faizaheljoasaariesta/monocopter/design/cup.stp

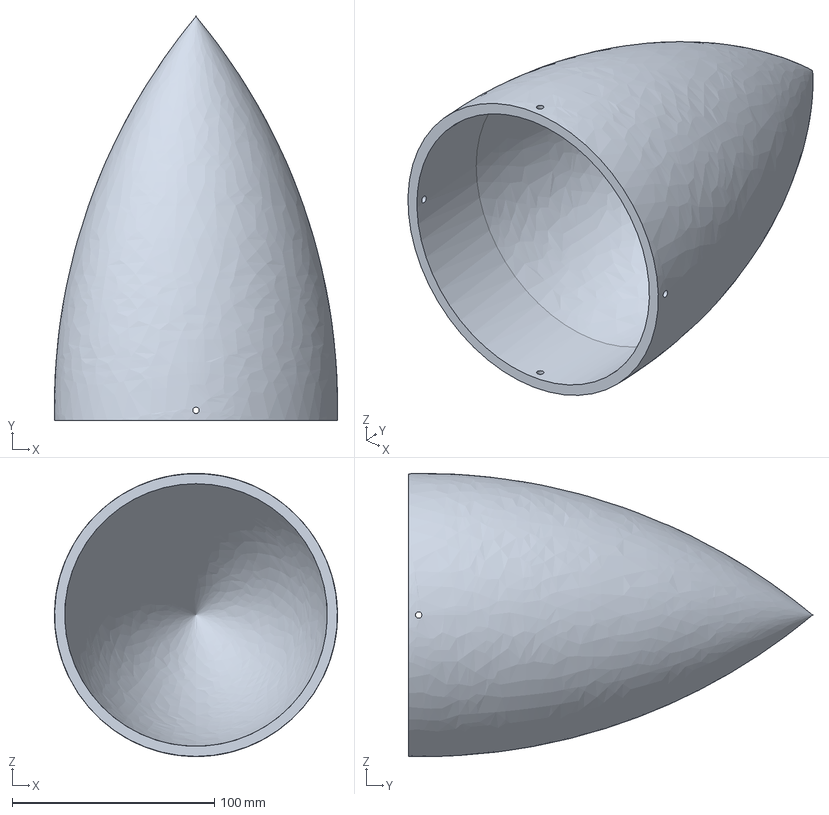
[picture p1: CAD file, 2026-10-10]
design/cup.stp
140.2 x 200.0 x 140.2 mm
