faizaheljoasaariesta/monocopter/design/battery_holder.stp

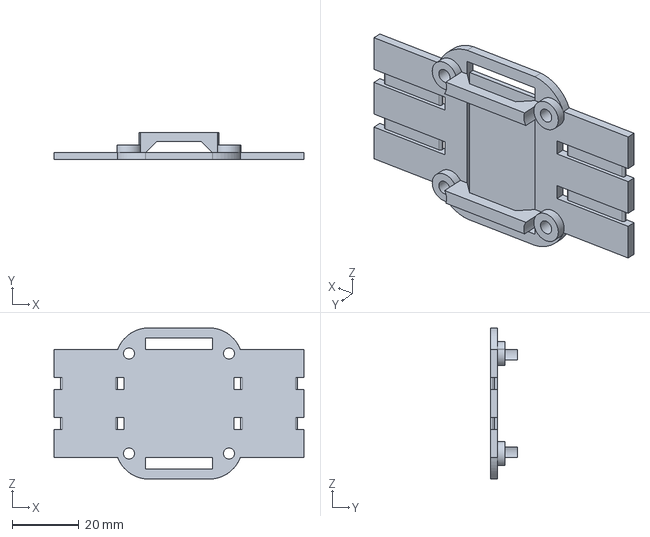
[picture p2: CAD file, 2026-10-10]
design/battery_holder.stp
75.0 x 8.20 x 45.3 mm
