faizaheljoasaariesta/monocopter/design/base_connection.stp

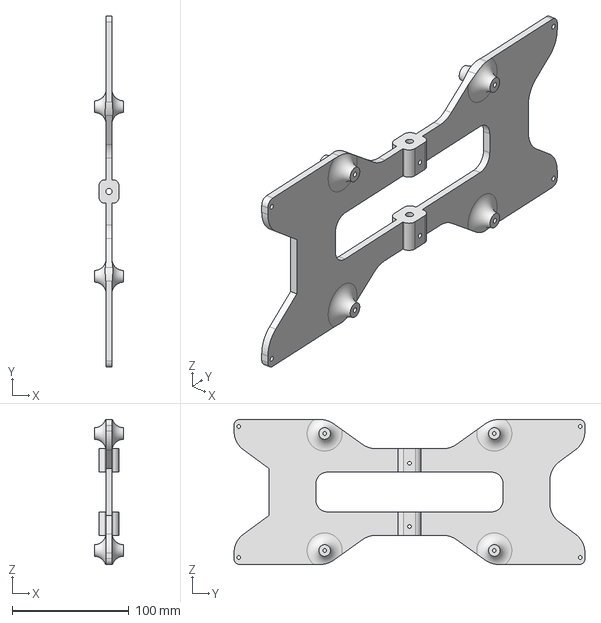
[picture p3: CAD file, 2026-10-10]
design/base_connection.stp
25.0 x 300.0 x 124.0 mm
