faizaheljoasaariesta/monocopter/design/body.stp

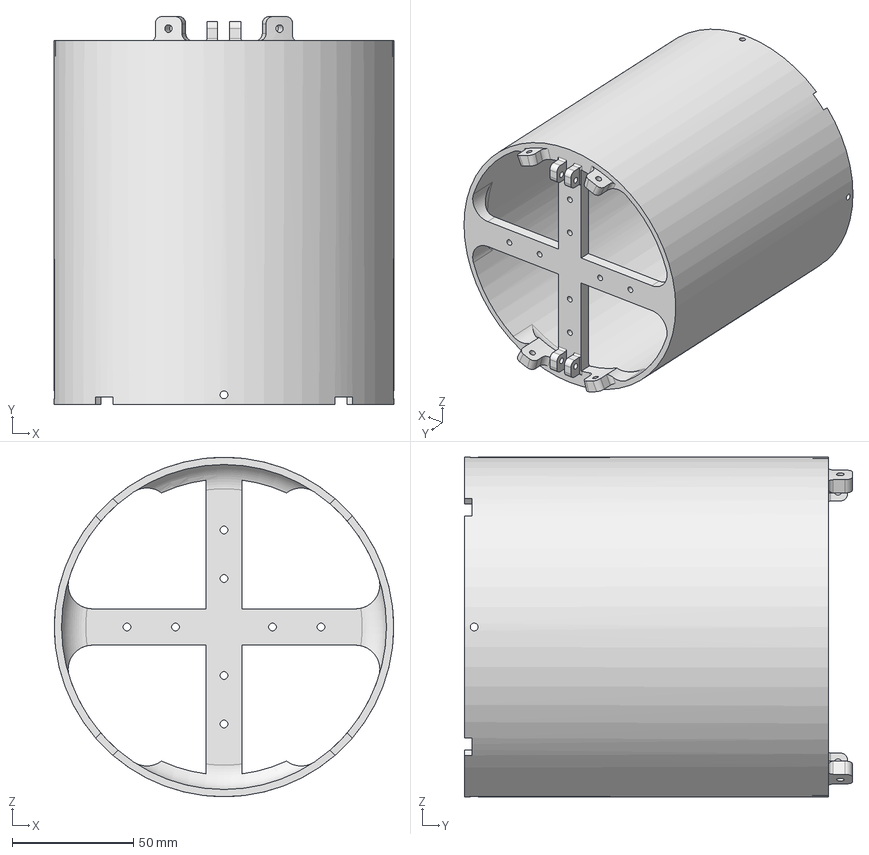
[picture p4: CAD file, 2026-10-10]
design/body.stp
140.0 x 160.0 x 140.0 mm
