faizaheljoasaariesta/monocopter/design/upper_ring.stp

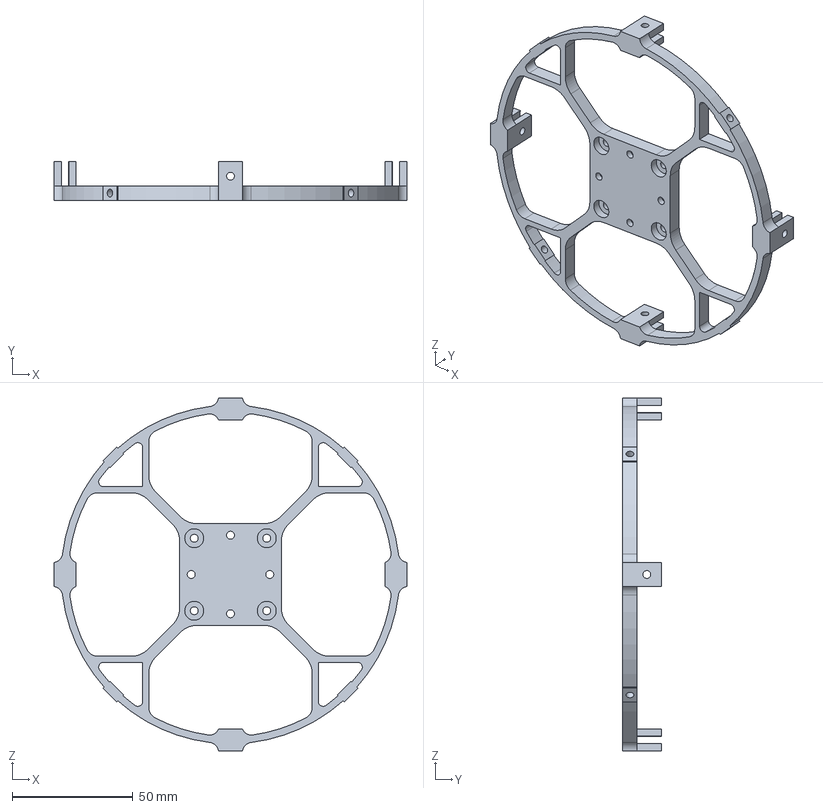
[picture p5: CAD file, 2026-10-10]
design/upper_ring.stp
146.0 x 16.0 x 146.0 mm
