faizaheljoasaariesta/monocopter/design/vane.stp

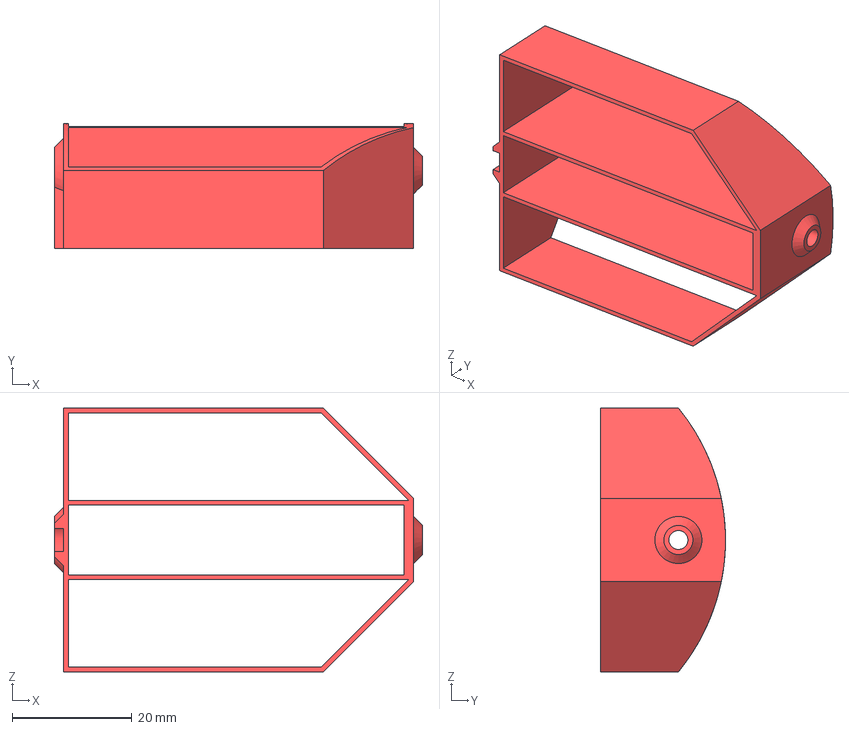
[picture p6: CAD file, 2026-10-10]
design/vane.stp
61.4 x 20.9 x 44.0 mm
