faizaheljoasaariesta/monocopter/design/lower_ring.stp

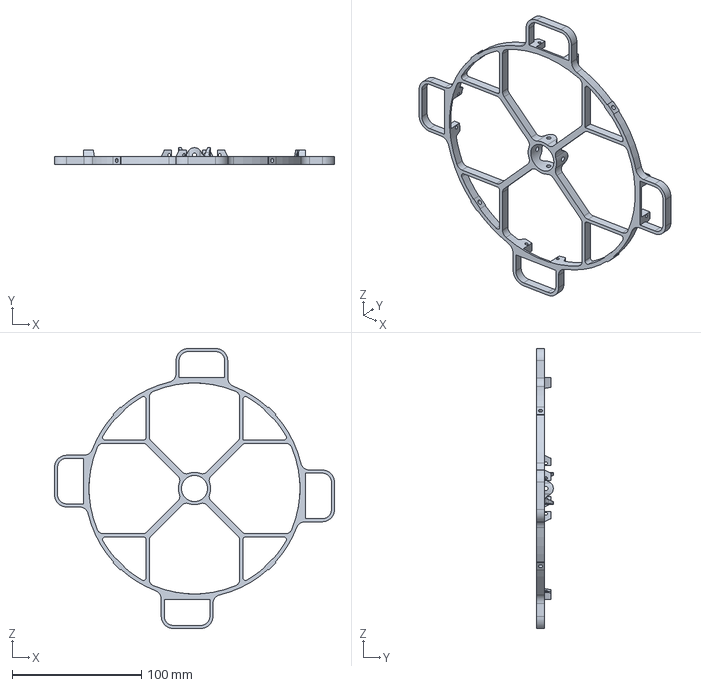
[picture p7: CAD file, 2026-10-10]
design/lower_ring.stp
216.6 x 12.8 x 216.6 mm
