faizaheljoasaariesta/monocopter/design/leg.stp

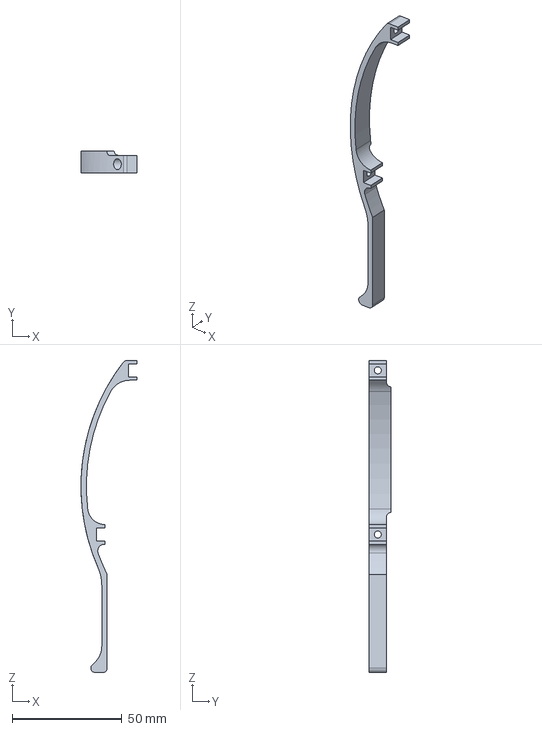
[picture p8: CAD file, 2026-10-10]
design/leg.stp
25.6 x 10.0 x 142.4 mm
