faizaheljoasaariesta/monocopter/design/body_middle.stp

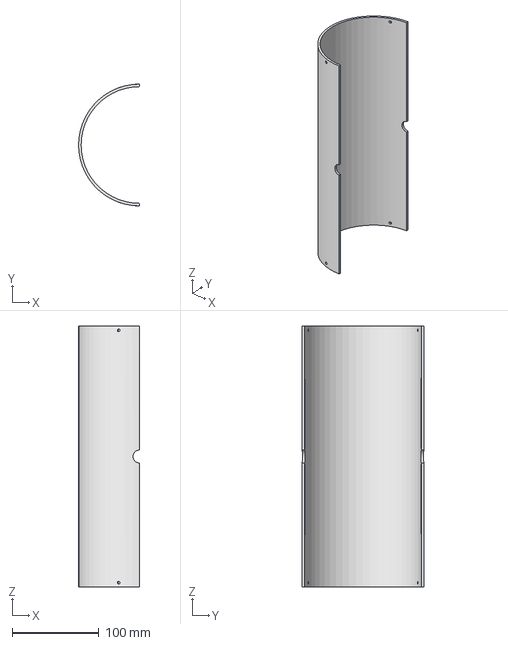
[picture p9: CAD file, 2026-10-10]
design/body_middle.stp
70.0 x 140.0 x 300.0 mm
