faizaheljoasaariesta/monocopter/design/body_top.stp

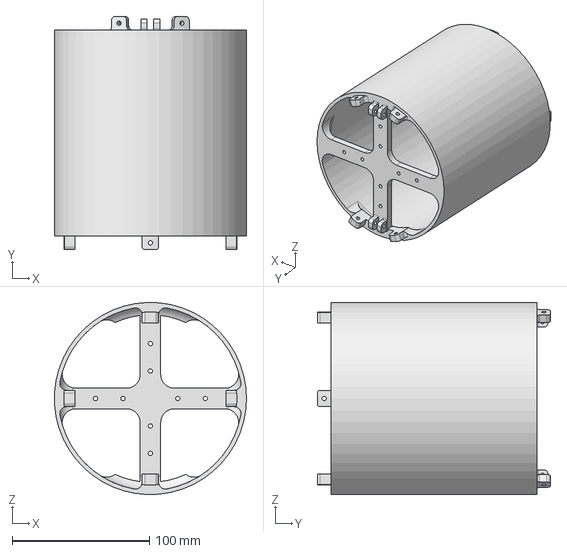
[picture p10: CAD file, 2026-10-10]
design/body_top.stp
139.9 x 170.0 x 139.9 mm
