faizaheljoasaariesta/monocopter/(notices)

Notices in the files:
README.MD:
License: MIT
